satirebird/thermodrive/thermodrive.step

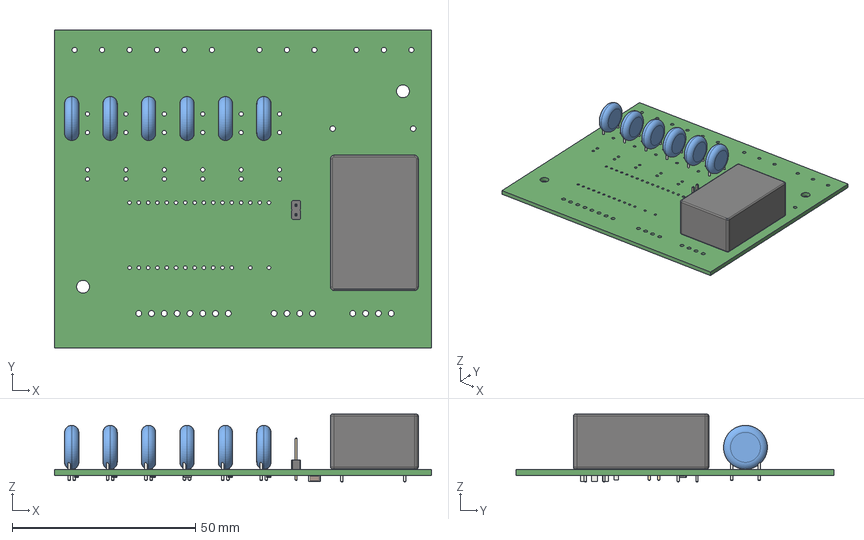
[picture p2: CAD file, 2020-11-01]
thermodrive.step
103.0 x 87.0 x 18.5 mm
