satirebird/thermodrive/thermodrive.kicad_pcb

## KiCad design thermodrive.kicad_pcb (2020-11-01)

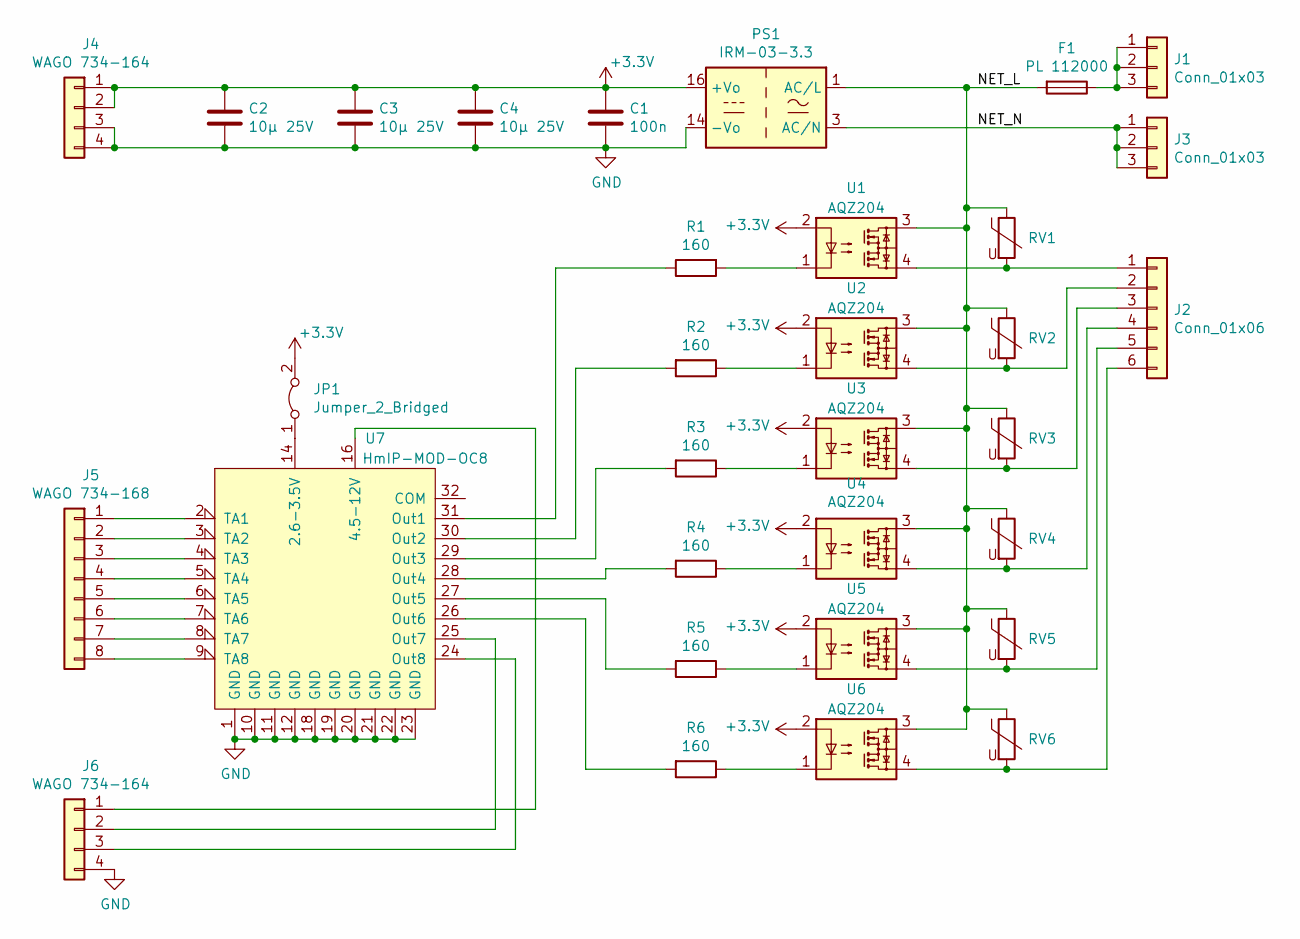
[picture p3: schematic thermodrive.sch]

Parts:
C1: 100n; C_0805_2012Metric
C2, C3, C4: 10µ 25V; C_1206_3216Metric
F1: PL 112000; Fuseholder5x20_horiz_SemiClosed_Casing10x25mm
J1, J3: Conn_01x03; TerminalBlock_MetzConnect_Type175_RT02703HBLC_1x03_P7.50mm_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
J2: Conn_01x06; TerminalBlock_MetzConnect_Type175_RT02706HBLC_1x06_P7.50mm_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
J4, J6: WAGO 734-164; Wago_734-164_1x04_P3.50mm_Horizontal
J5: WAGO 734-168; Wago_734-168_1x08_P3.50mm_Horizontal
JP1: Jumper_2_Bridged; PinHeader_1x02_P2.54mm_Vertical
PS1: IRM-03-3.3; Converter_ACDC_MeanWell_IRM-03-xx_THT
R1, R2, R3, R4, R5, R6: 160; R_0805_2012Metric
RV1, RV2, RV3, RV4, RV5, RV6: B72210P2271K101; RV_Disc_D12mm_W3.9mm_P7.5mm
U1, U2, U3, U4, U5, U6: AQZ204; AQZ-SIL-4
U7: HmIP-MOD-OC8

Connections:
+3V3: C1.1, C2.1, C3.1, C4.1, J4.1, J4.2, JP1.2 (B), PS1.16 (+Vo), U1.2, U2.2, U3.2, U4.2, U5.2, U6.2
/NET_L: F1.2, PS1.1 (AC/L), RV1.1, RV2.1, RV3.1, RV4.1, RV5.1, RV6.1, U1.3, U2.3, U3.3, U4.3, U5.3, U6.3
/NET_N: J3.1, J3.2, J3.3, PS1.3 (AC/N)
GND: C1.2, C2.2, C3.2, C4.2, J4.3, J4.4, J6.4, PS1.14 (-Vo), U7.1 (GND), U7.10 (GND), U7.11 (GND), U7.12 (GND), U7.18 (GND), U7.19 (GND), U7.20 (GND), U7.21 (GND), U7.22 (GND), U7.23 (GND)
unnamed: F1.1, J1.1, J1.2, J1.3
unnamed: J2.1, RV1.2, U1.4
unnamed: J2.2, RV2.2, U2.4
unnamed: J2.3, RV3.2, U3.4
unnamed: J2.4, RV4.2, U4.4
unnamed: J2.5, RV5.2, U5.4
unnamed: J2.6, RV6.2, U6.4
unnamed: J5.1, U7.2 (TA1)
unnamed: J5.2, U7.3 (TA2)
unnamed: J5.3, U7.4 (TA3)
unnamed: J5.4, U7.5 (TA4)
unnamed: J5.5, U7.6 (TA5)
unnamed: J5.6, U7.7 (TA6)
unnamed: J5.7, U7.8 (TA7)
unnamed: J5.8, U7.9 (TA8)
unnamed: J6.1, U7.16 (4.5-12V)
unnamed: J6.2, U7.25 (Out7)
unnamed: J6.3, U7.24 (Out8)
unnamed: JP1.1 (A), U7.14 (2.6-3.5V)
unnamed: R1.1, U7.31 (Out1)
unnamed: R1.2, U1.1
unnamed: R2.1, U2.1
unnamed: R2.2, U7.30 (Out2)
unnamed: R3.1, U3.1
unnamed: R3.2, U7.29 (Out3)
unnamed: R4.1, U4.1
unnamed: R4.2, U7.28 (Out4)
unnamed: R5.1, U5.1
unnamed: R5.2, U7.27 (Out5)
unnamed: R6.1, U6.1
unnamed: R6.2, U7.26 (Out6)

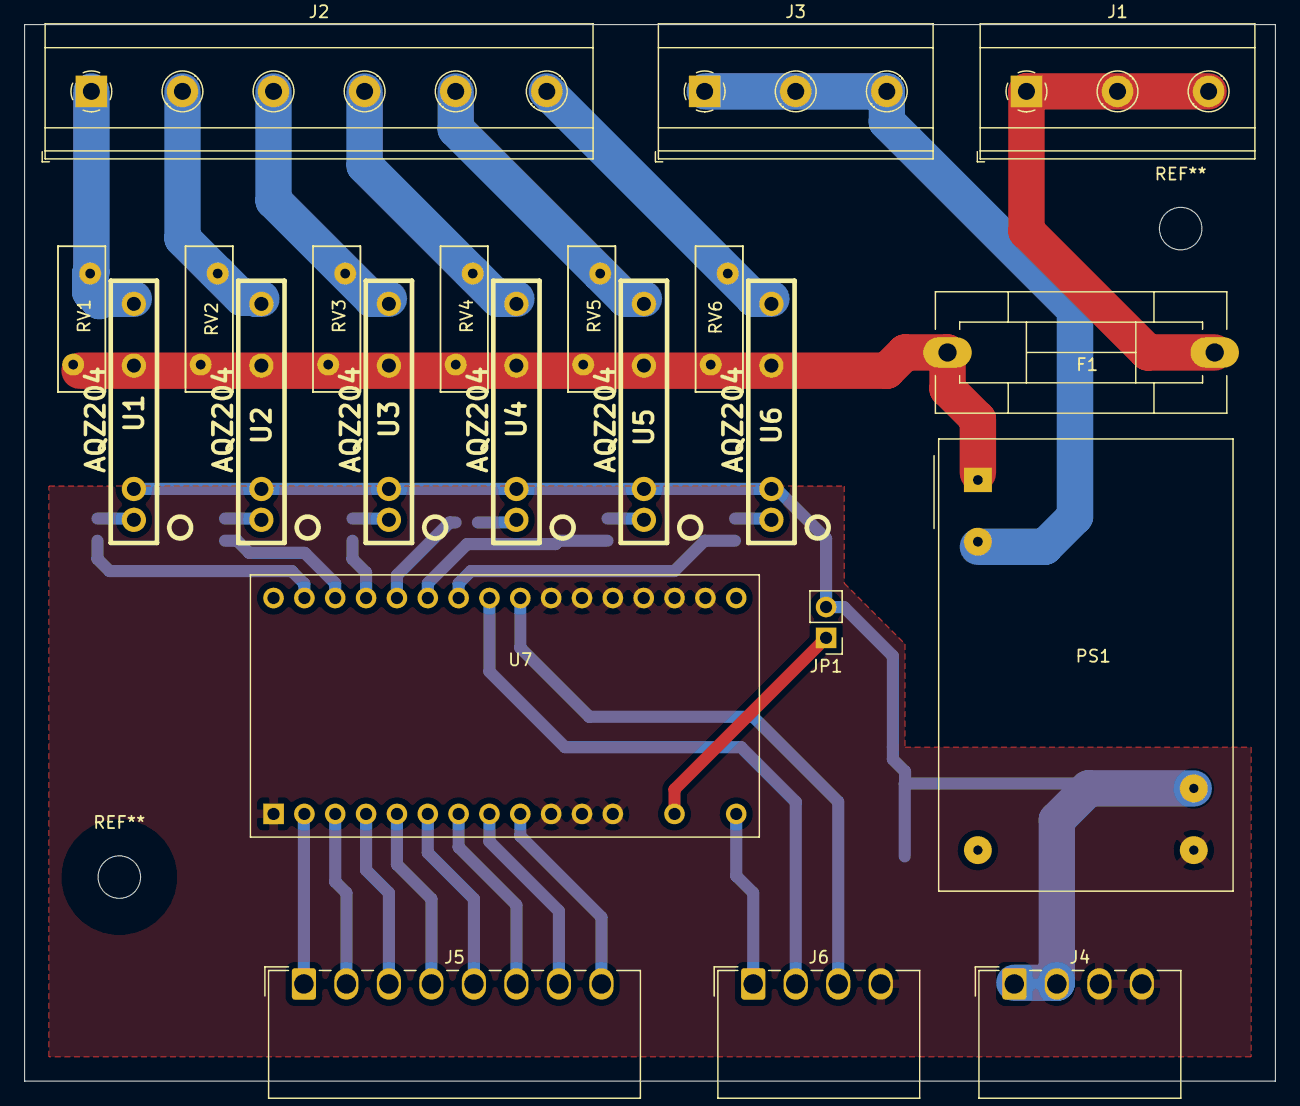
[picture p4: board thermodrive.kicad_pcb from above]

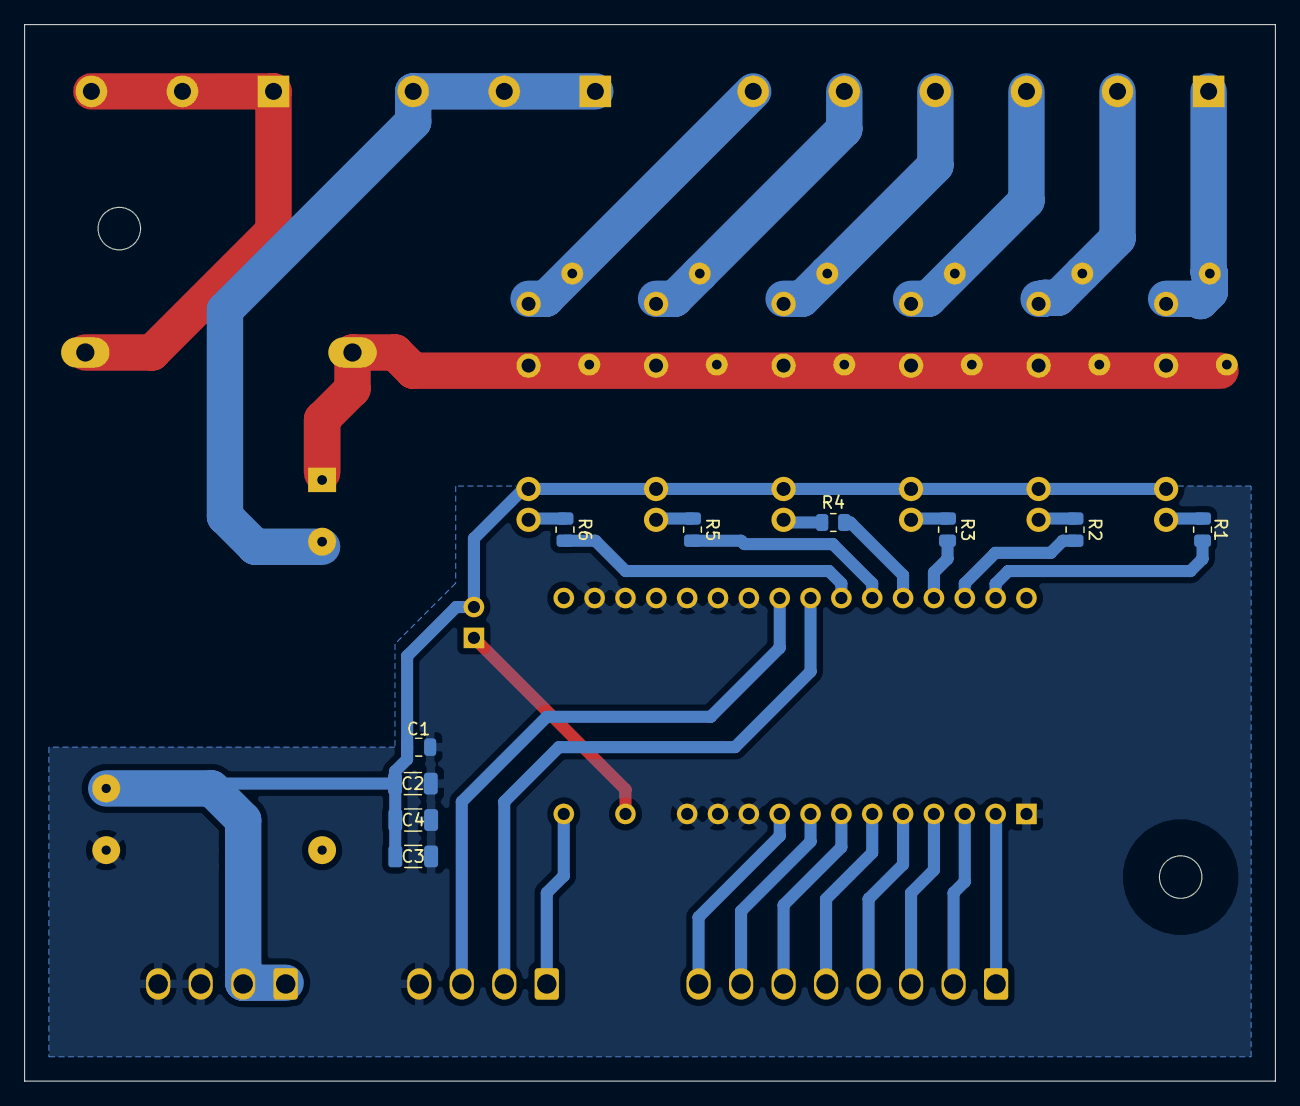
[picture p5: board thermodrive.kicad_pcb from below]

Board: 2 copper layers, 103.0 x 87.0 mm, 32 parts (10 on the bottom side), 35 nets.
